cyysu/YSU-/README.md

# YSU-
燕山大学毕业设计-5V2A手机充电器设计，包括了原理图，PCB，开题报告，中期答辩以及最终的论文
