cyysu/YSU-/开题报告.pdf

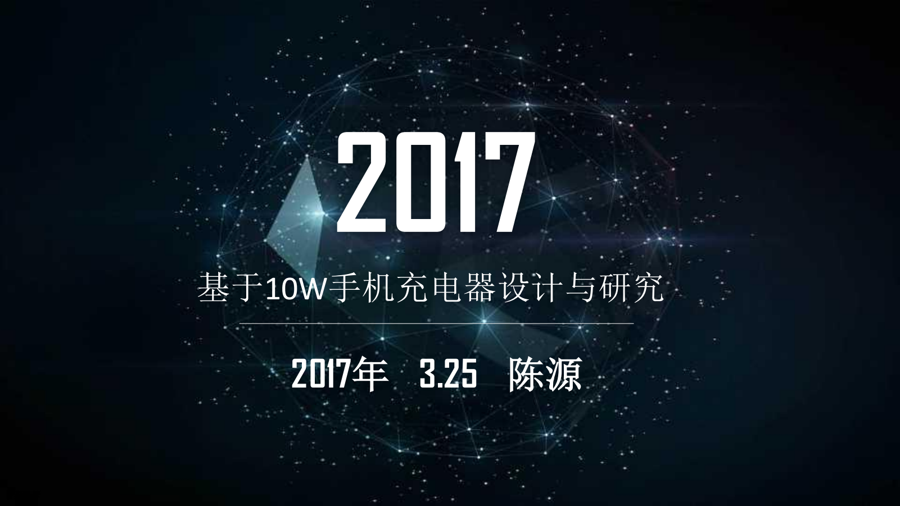
[picture p28: page 1]

# 基于10W手机充电器设计与研究

2017

PPT模板下载：www. 1ppt . com/ moban/ 行业PPT模板：www. 1ppt. com/ hangye/ 节日PPT模板：www. 1ppt . com/ jier i/ PPT素材下载：www. 1ppt .com/ sucai/ PPT背景图片：www. 1ppt . com/ beijng/ PPT图表下载：www. 1ppt .com/t ubiao/ 优秀PPT下载：www. 1ppt . com/ xiazai/ PPT教程：www. 1ppt . com/ power point/ Wor d教程：www. 1ppt . com /wor d/ Excel教程：www. 1ppt . com/ excel/ 资料下载：www. 1ppt . com /zilao/ PPT课件下载：www. 1ppt . com/ kejian/ 范文下载：www. 1ppt . com /f anwen/ 试卷下载：www. 1ppt . com/ shit i/ 教案下载：www. 1ppt . com /jiaoan/ PPT论坛：www. 1ppt . cn

# 2017年 3.25 陈源

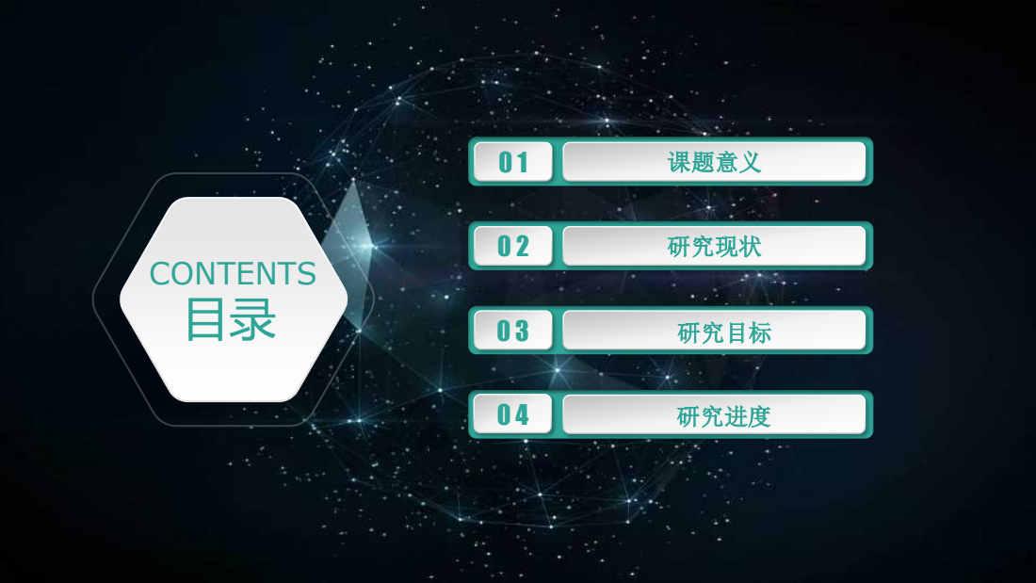
[picture p29: page 2]
CONTENTS; 课题意义; 研究现状; 研究目标; 研究进度

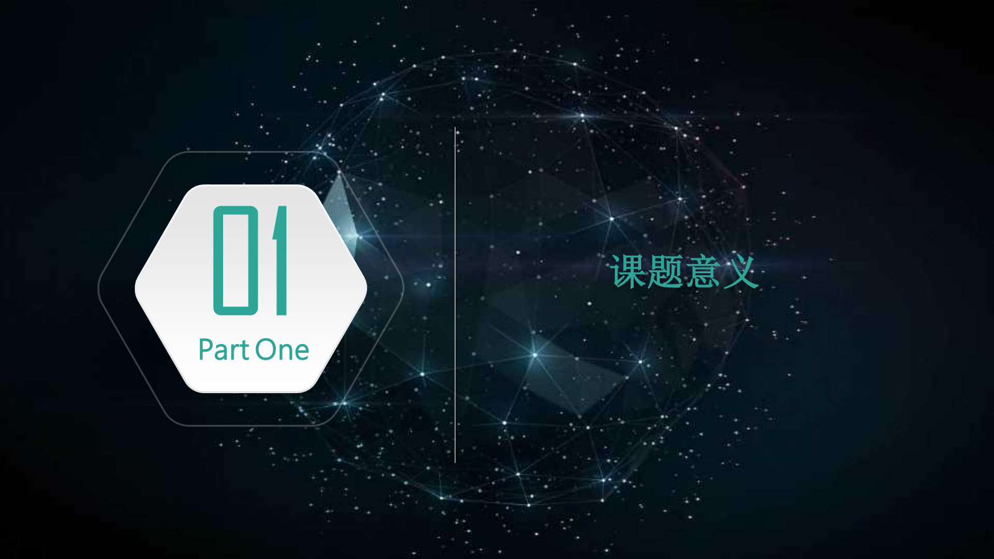
[picture p30: page 3]

01

# Part One

# 课题意义

# 01 研究意义

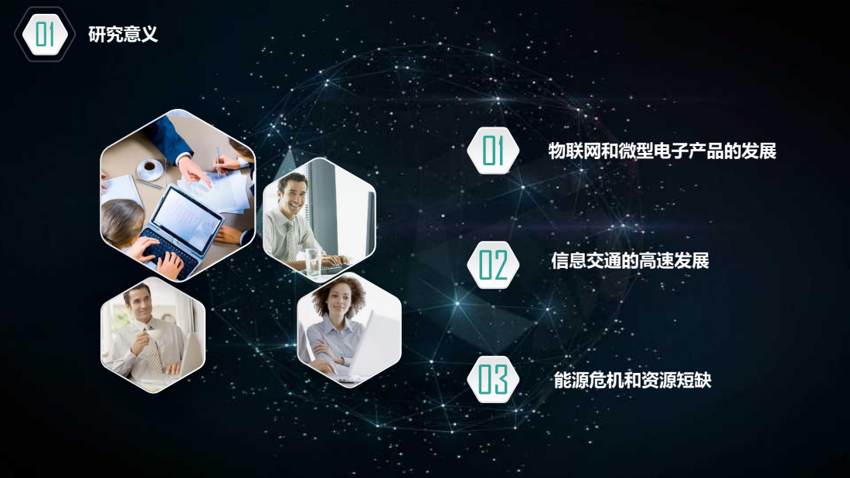
[picture p31: page 4]
物联网和微型电子产品的发展; 信息交通的高速发展; 能源危机和资源短缺

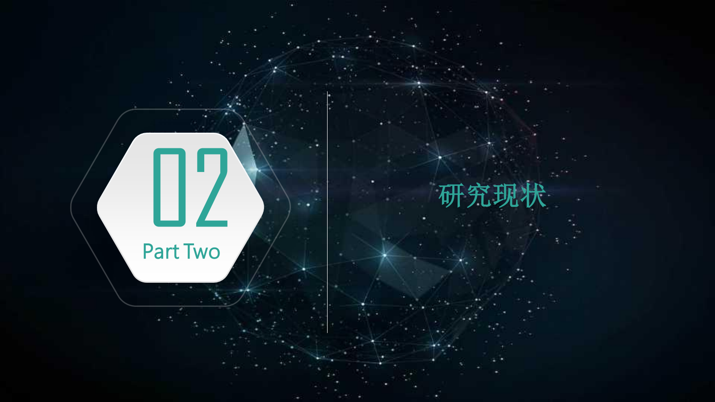
[picture p32: page 5]

02

# Part Two

# 研究现状

# 在QC2.0电压基础

# 上，采用独特INOV

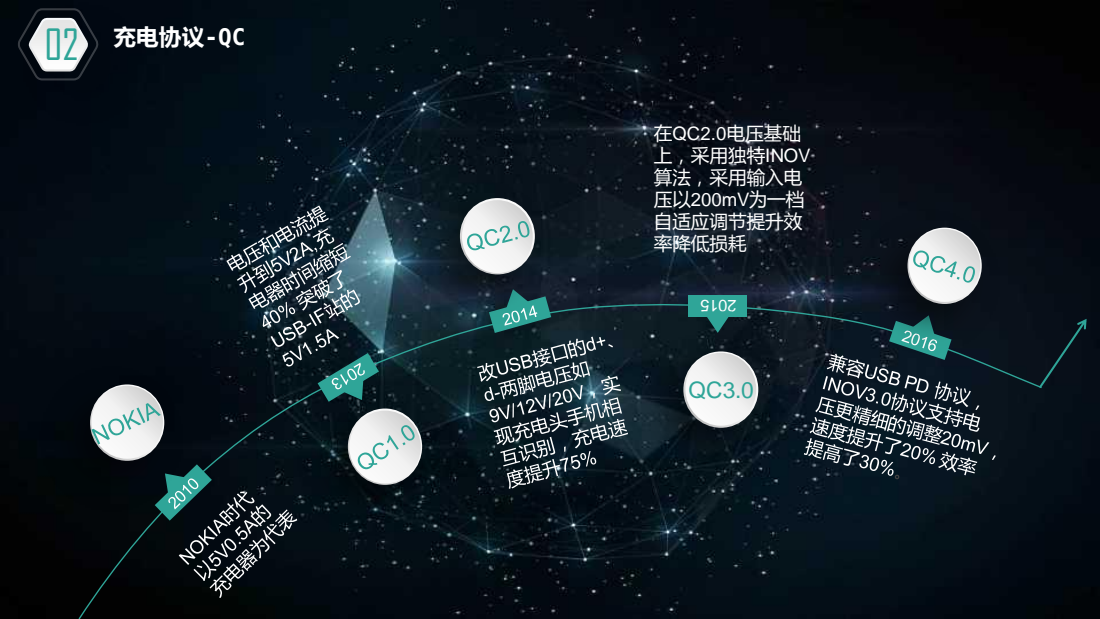
[picture p33: page 6]
算法，采用输入电 压以200mV为一档 自适应调节提升效 率降低损耗; 充电协议 -QC 02

# 接口标准 02

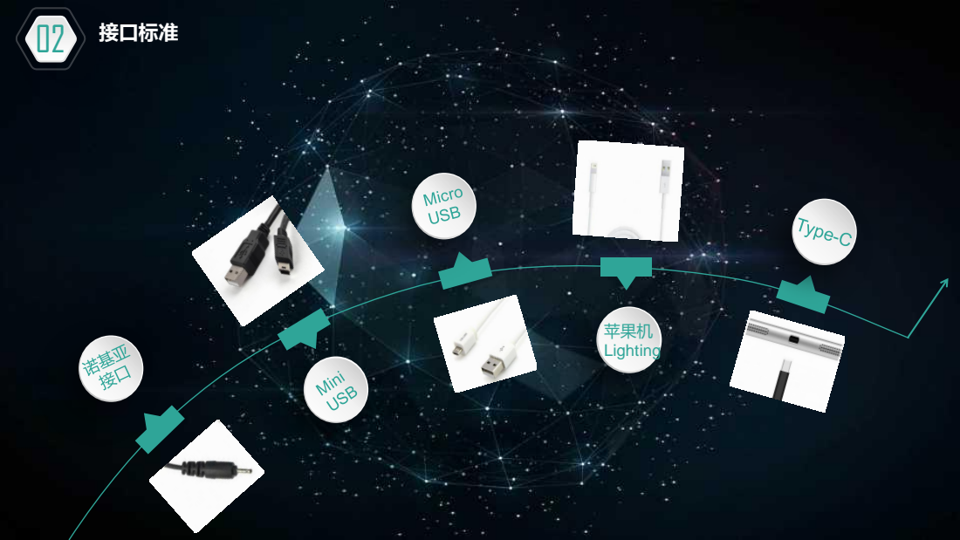
[picture p34: page 7]
苹果机 Lighting

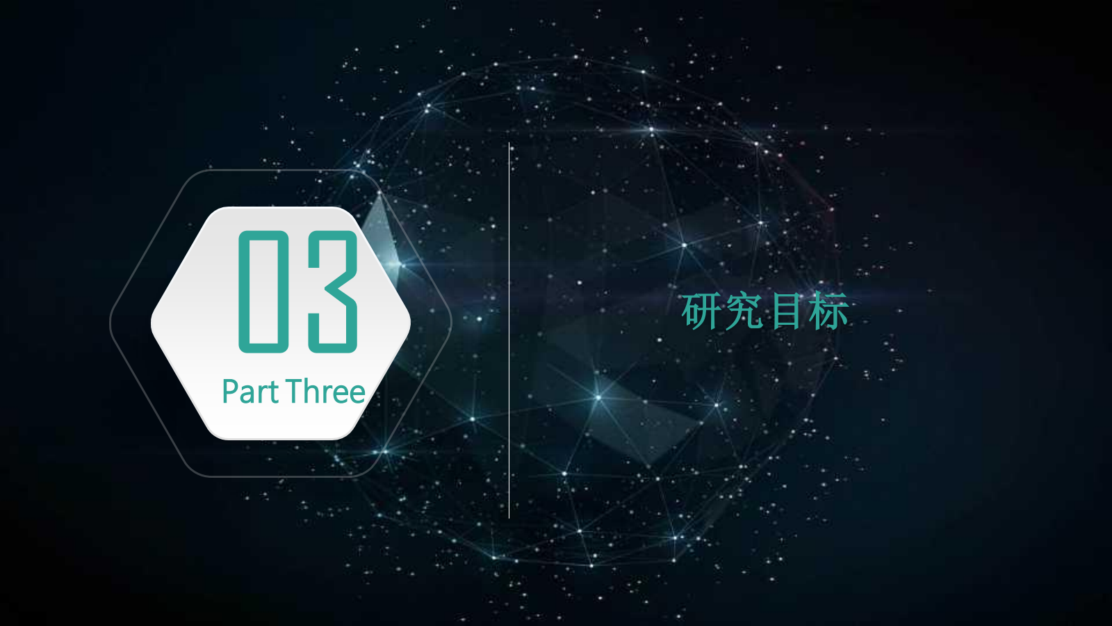
[picture p35: page 8]

03

# Part Three

# 研究目标

# 本课题主要针对以下三种方案进行理论分析，就其中一种或两种方案进行实物制作

# 03 研究方案

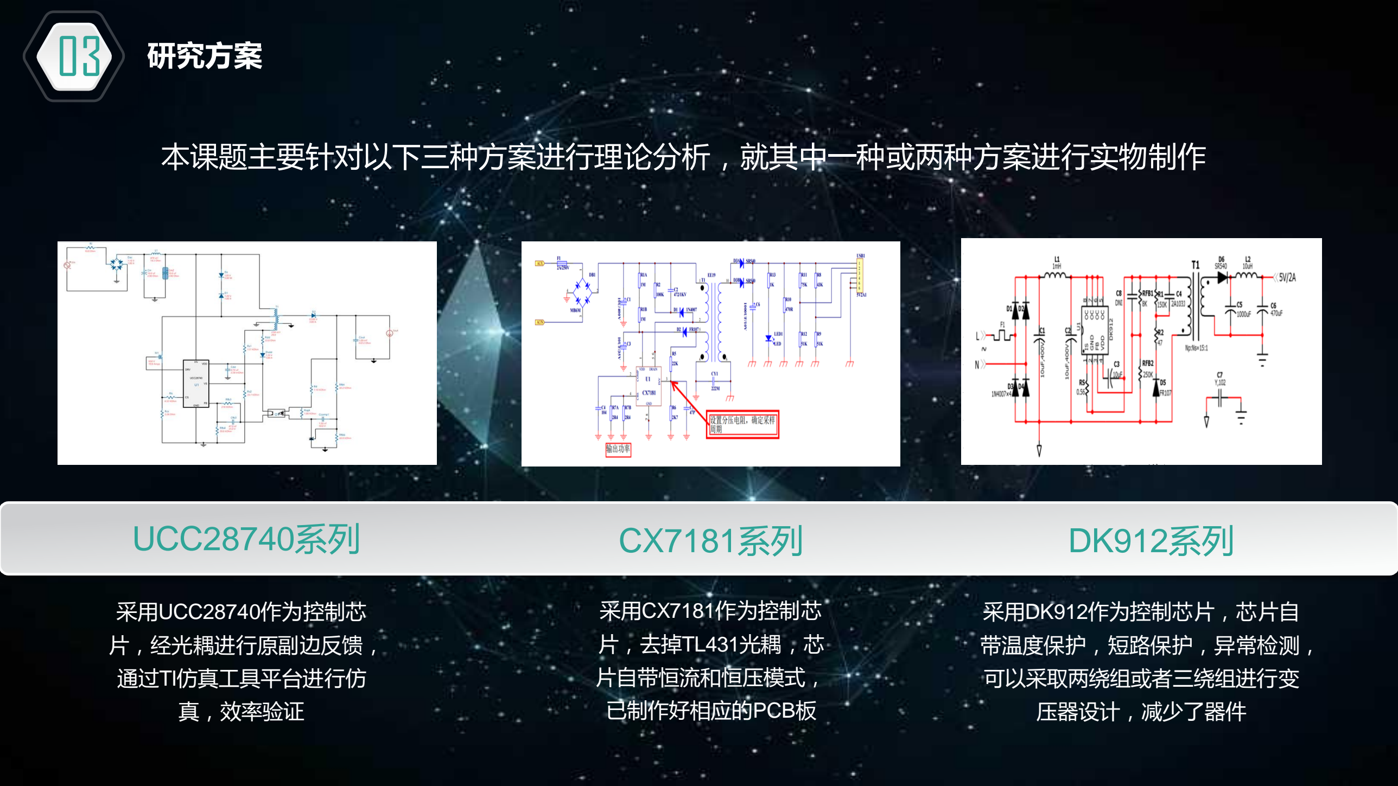
[picture p36: page 9]

# UCC28740系列

# 采用UCC28740作为控制芯

# 片，经光耦进行原副边反馈， 通过TI仿真工具平台进行仿 真，效率验证

# CX7181系列

# 采用CX7181作为控制芯

# 片，去掉TL431光耦，芯

# 片自带恒流和恒压模式， 已制作好相应的PCB板

# DK912系列

# 采用DK912作为控制芯片，芯片自

# 带温度保护，短路保护，异常检测，

# 可以采取两绕组或者三绕组进行变

# 压器设计，减少了器件

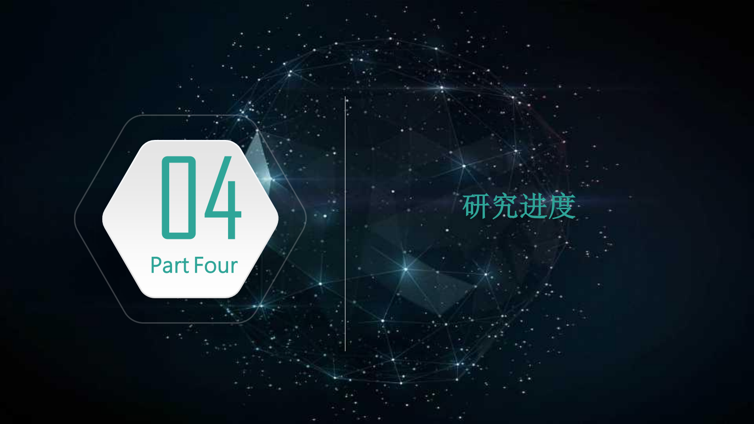
[picture p37: page 10]

04

# Part Four

# 研究进度

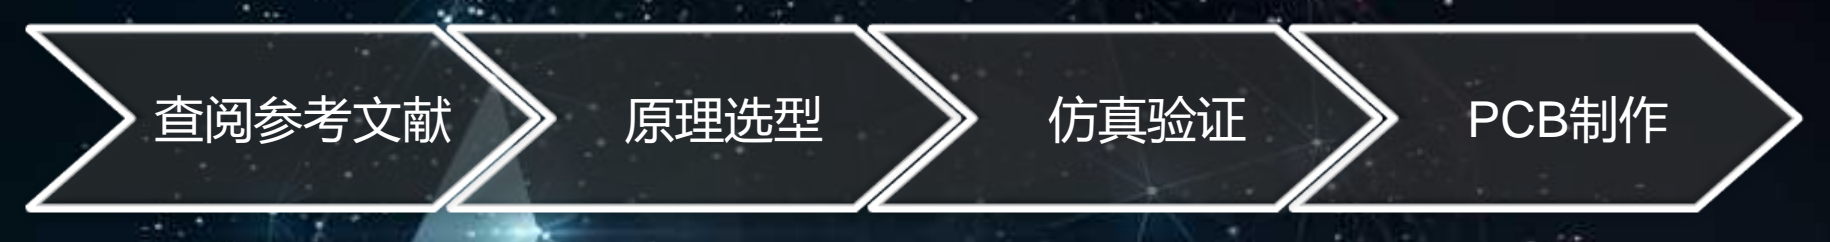
[picture p38: figure]
查阅参考文献; 原理选型; 仿真验证; PCB制作

# 初步选定以上三 种研究方案

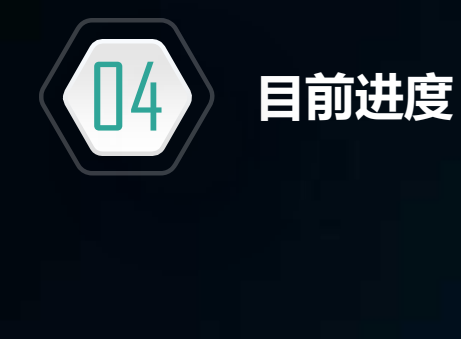
[picture p39: figure]
04 目前进度

# 查阅近3年内充

# 电器新型技术

# TI平台仿真验证 已初步分析

# CX7181元器件、电

# 路板准备完毕

# 附 充电器接口趋势图

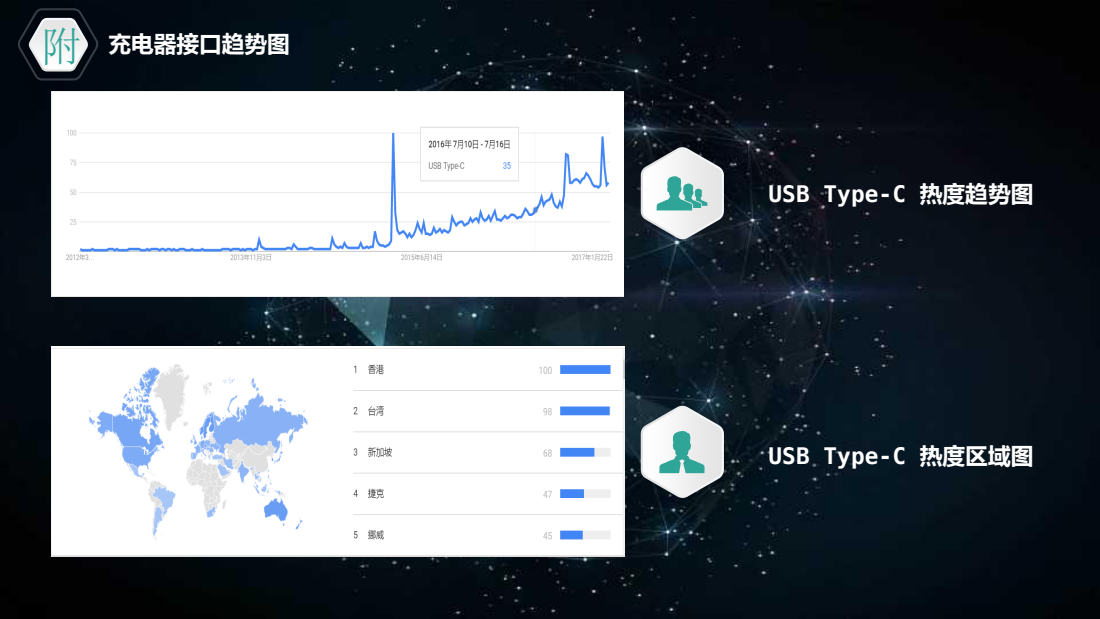
[picture p40: page 12]

USB Type-C 热度趋势图

USB Type-C 热度区域图

2017

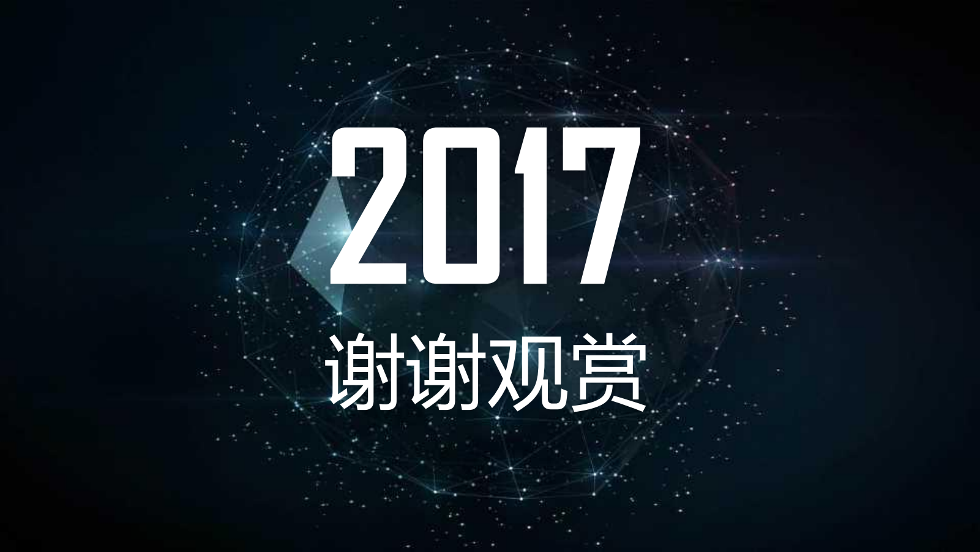
[picture p41: page 13]

# 谢谢观赏
