cyysu/YSU-/CX7181-0827/BOM for CX7181.xls

名称 | 封装 | 规格参数 | 数量 | 位置编号
贴片电容 | 0603 | 102 | 1 | C7
 | 0603 | 104 | 2 | C5 | C10
 | 0603 | 47P | 1 | C6
贴片电阻 | 0603 | 2.7K1% | 1 | R5
 | 0603 | 20K1% | 1 | R4
 | 0603 | 22R | 1 | R8
 | 0603 | 43K | 1 | R14
 | 0603 | 51K | 2 | R15 | R16
 | 0603 | 75K | 1 | R13
 | 0805 | 1M | 2 | R1 | R2
 | 0805 | 560R | 1 | R9
 | 1206 | 100K | 1 | R3
 | 1206 | 2.2R | 2 | R6 | R7
整流桥 | MBM | MB6M | 1 | DB1
电解电容 | 10*13 | 10uF/400V | 1 | C1
 | 4*7 | 10UF/35V | 1 | C4
 | 8*12 | 1000UF/10V | 1 | C8
瓷片电容 |  | 222/1KV | 1 | C3
安规Y电容 |  | 222M | 1 | CY1
二极管 | DO-41 | 1N4007 | 1 | D1
 | DO-15 | SR540 | 2 | D3 | D4
 | DO-41 | FR107 | 1 | D2
IC | DIP8 | CX7181 | 1 | U1
变压器 | EE19L4+3 | EE19 | 1 | T1
保险丝 |  | 2A/250V | 1 | F1
USB |  |  | 1 | USB
