cyysu/YSU-/TXY2685-四海通-ATC9213+9200D-5V2A/ATC9213 EE16不过认证 5V2A BOM .xls

5V2A充电配器成品物料明细
序号 |  | 元件名称 | 规格描述 | 用量
1 | R14 | PCB |  | 1
2 | BD1 | 桥堆 | Bridge Rectifiers MB10FM SOPA-4 (ROHS) | 1
3 | U1 | IC | Power Control IC ATC9213 SOP-7(ROHS) | 1
4 | U2 | IC | Power Control IC ATC9200D SOP-8(ROHS) | 1
5 | D1 D2 | 二极管 | F7 0.5A 1KV SOD-123FL | 2
6 | R1 R2 | 贴片电阻 | Chip resistor 1.4Ω±5% 1/4W 1206 (ROHS) | 2
7 | R3 | 贴片电阻 | Chip resistor 2MΩ±5% 1/4W 1206 (ROHS) | 1
8 | R4 | 贴片电阻 | Chip resistor 100KΩ±5% 1/4W 1206 (ROHS) | 1
9 | R5 | 贴片电阻 | Chip resistor 18KΩ±1% 1/8W 0805 (ROHS) | 1
10 | R6 | 贴片电阻 | Chip resistor 3KΩ±1% 1/8W 0805 (ROHS) | 1
11 | R7 | 贴片电阻 | Chip resistor 1KΩ±5% 1/8W 0805 (ROHS) | 1
12 | R8 | 贴片电阻 | Chip resistor 22Ω±5% 1/12W 0603 (ROHS) | 1
13 | R9 | 贴片电阻 | Chip resistor 270Ω±5% 1/12W 0603 (ROHS) | 1
14 | R10 | 贴片电阻 | Chip resistor 27KΩ±5% 1/12W 0603 (ROHS) | 1
15 | R11 | 贴片电阻 | Chip resistor 1KΩ±5% 1/12W 0603 (ROHS) | 1
16 | R12 | 贴片电阻 | Chip resistor 110KΩ±5% 1/12W 0603 (ROHS) | 1
17 | R13 | 贴片电阻 | Chip resistor 330KΩ±5% 1/12W 0603 (ROHS) | 1
18 | R14 | 贴片电阻 | Chip resistor 43KΩ±5% 1/12W 0603 (ROHS) | 1
19 | R15 R16 | 贴片电阻 | Chip resistor 51KΩ±5% 1/12W 0603 (ROHS) | 2
20 | R17 | 贴片电阻 | Chip resistor 75KΩ±5% 1/12W 0603 (ROHS) | 1
21 | C1 | 贴片电容 | Chip Cap 102±20% 500V 0805 (ROHS) | 1
22 | C2 | 贴片电容 | Chip Cap 472±20% 50V 0603 (ROHS) | 1
23 | C3 | 贴片电容 | Chip Cap 105±20% 50V 0603 (ROHS) | 1
插件
24 | F1 | 保险丝电阻 | 4.7R/1/2W 绕线电阻 | 1
25 | EC1 | 电解电容 | E.Cap 10UF/400V±20% Φ8*13mm 105℃(ROHS+PET) | 1
26 | EC2 | 电解电容 | E.Cap 10UF/50V±20% Φ4*7mm 105℃(ROHS+PET) | 1
27 | EC3 EC4 | 电解电容 | E.Cap 470UF/6.3V±20% Φ6*12mm 高频低阻 | 2
28 | CY1 | 瓷片电容 | 高压瓷片 102/1KV 脚距5MM | 1
29 | T1 | 变压器 | EE16 L=1.0mH (5+5)(ROHS) | 1
30 | LED1 |  |  | 1
31 | USB1 USB2 |  |  | 2
