cyysu/YSU-/现阶段研究的AT9213方案/ATC9213 EE16 5V2A BOM.xls

5V2A充电配器成品物料明细
序号 | 元件代码 | 元件名称 | 规格描述 | 用量
1 | PCB板 | PCB |  | 1
2 | BD1 | 桥堆 | Bridge Rectifiers MB10FM SOPA-4 (ROHS) | 1
3 | IC1 | IC | Power Control IC ATC9213 SOP-8(ROHS) | 1
4 | D1 D2 | 二极管 | A7 0.5A 1KV SOD-123FL | 2
5 | R1 R2 | 贴片电阻 | Chip resistor 1MΩ±5% 1/4W 1206 (ROHS) | 2
6 | R3 R4 | 贴片电阻 | Chip resistor 1.3Ω±5% 1/4W 1206 (ROHS) | 2
7 | R5 | 贴片电阻 | Chip resistor 100KΩ±5% 1/4W 1206 (ROHS) | 1
8 | R7 | 贴片电阻 | Chip resistor 3.3KΩ±1% 1/8W 0805 (ROHS) | 1
9 | R8 | 贴片电阻 | Chip resistor 21KΩ±5% 1/8W 0805 (ROHS) | 1
10 | R9 | 贴片电阻 | Chip resistor 470Ω±5% 1/8W 0805 (ROHS) | 1
11 | R10 | 贴片电阻 | Chip resistor 10Ω±5% 1/8W 0805 (ROHS) | 1
12 | R12 | 贴片电阻 | Chip resistor 100Ω±5% 1/8W 0805 (ROHS) | 1
13 | C3 | 贴片电容 | Chip Cap 102±20% 50V 0805 (ROHS) | 1
插件
14 | F1 | 保险丝 | T1A250VAC 插件 3.6*10mm (ROHS) | 1
15 | CY1 | Y电容 | Y电容 222 400V ±20% 脚距:10mm F(JD) | 1
16 | C1 | 高压瓷片电容 | 102/1KV 脚距：5mm | 1
17 | EC1 EC2 | 电解电容 | E.Cap 6.8UF/400V±20% Φ8*14mm 105℃(ROHS+PET) | 2
18 | EC3 | 电解电容 | E.Cap 10UF/50V±20% Φ4*7mm | 1
19 | EC4 EC5 | 电解电容 | E.Cap 470UF/6.3V±20% Φ6.3*12mm 高频低阻 | 2
20 | D3 | 二极管 | S-Diode SR540L 5A/40V DO-201 | 1
21 | L1 | 跳线 | 0.6MM*4.5MM跳线 | 1
22 | T1 | 变压器 | EE16 V01 L=1.0mH (5+5)(ROHS) | 1
23 | USB |  |  | 1
