cyysu/YSU-/CX7181-0827/cx7181 EPC17骨架的变压器资料.xls

变压器规格书
用途： |  |  |  |  |  | 标贴型号 | ：CX7181-10W
名称： | 10W-CX7181 |  |  |  | √ | 打样数量：5只
样品版本：V1.0 |  |  |  |  |  | 交样日期 ： 月 日
磁芯规格：EPC17卧式 TDK PC40 |  |  |  | 骨架规格：EPC17 6+4脚
 |  |  |  |  |  | outside
 |  |  |  | top
 | 原理图 |  |  |  |  | N3
 |  |  |  |  |  | N2
 |  |  |  | bottom |  | N1
绕 组 | 引脚 | 线径 | 匝数 | 参考要求 | 上端间距 | 下端间距 | 胶带层数 | 绕制方法
N1 | 5--1 | Φ0.23×1 | 110T | 初级绕组 |  |  | 底层 | 三层密绕
N2 | 7--10 | Φ0.45*2 | 9T | 5V/2.1A |  |  | 3 | 两层密绕
N3 | 6--3 | Φ0.23×1 | 26T | 15V/10mA |  |  | 3 | 密绕铺满
注: | 分压电阻为21K:3K
技术要求： | 1、N1.N3.N4为原边，N2为副边。
 | 2、如果不能绕制整层，就平均疏绕整层。
 | 3、浸漆绝缘处理。
初级电感量920uH±3%,短路次级漏感小于50uH,磁芯气隙0.3mm(参考值）。
1、安规绝缘符合国标GB8898-1997的相关要求。辐射干扰符合国标GB13837的相关要求。 2、若有不足以满铺整层，请稀绕铺满。 3、变压器谐振频率应在1MHz以上。（Dmax=0.55 F=100KHz)
