cyysu/YSU-/CX7181-0827/7181 EE19变压器资料4+3.xls

变压器规格书
用途： |  |  |  |  |  | 标贴型号 | ：CXW7181-10W
名称： | 10W-CXW7181 |  |  |  | √ | 打样数量：5只
样品版本：V1.0 |  |  |  |  |  | 交样日期 ： 月 日
磁芯规格：EE19立式 TDK PC40 |  |  |  | 骨架规格：EE19 4+3脚（脚距4mm,排距11mm)
 |  |  |  | top
 | 原理图 |  |  |  |  | N3
 |  |  |  |  |  | N2
 |  |  |  | bottom |  | N1
绕 组 | 引脚 | 线径 | 匝数 | 绕组名称 | 绕向 | 绕制方法 | 胶带层数 | 备注
N1 | 3--4 | Φ0.23×1 | 110T | 初级绕组 | 顺时针 | 三层密绕 | 底层
N2 | 7--5 | 0.45*2 | 9T | 次级绕组 | 顺时针 | 平均铺满 | 3
N3 | 1--2 | Φ0.23×1 | 27T | 反馈绕组 | 顺时针 | 平均铺满 | 3
 |  |  |  |  |  |  | 外2层
注:
技术要求：
 | 1、真空浸漆绝缘处理。
 | 2、3750V打高压
初级电感量930UH±3%,短路次级漏感小于50uH,磁芯气隙0.3mm(参考值）。
1、安规绝缘符合国标GB8898-1997的相关要求。辐射干扰符合国标GB13837的相关要求。 2、若有不足以满铺整层，请稀绕铺满。 3、变压器谐振频率应在1MHz以上。（Dmax=0.55 F=100KHz)
