cyysu/YSU-/CX7181-0827/插件贴片图.pdf

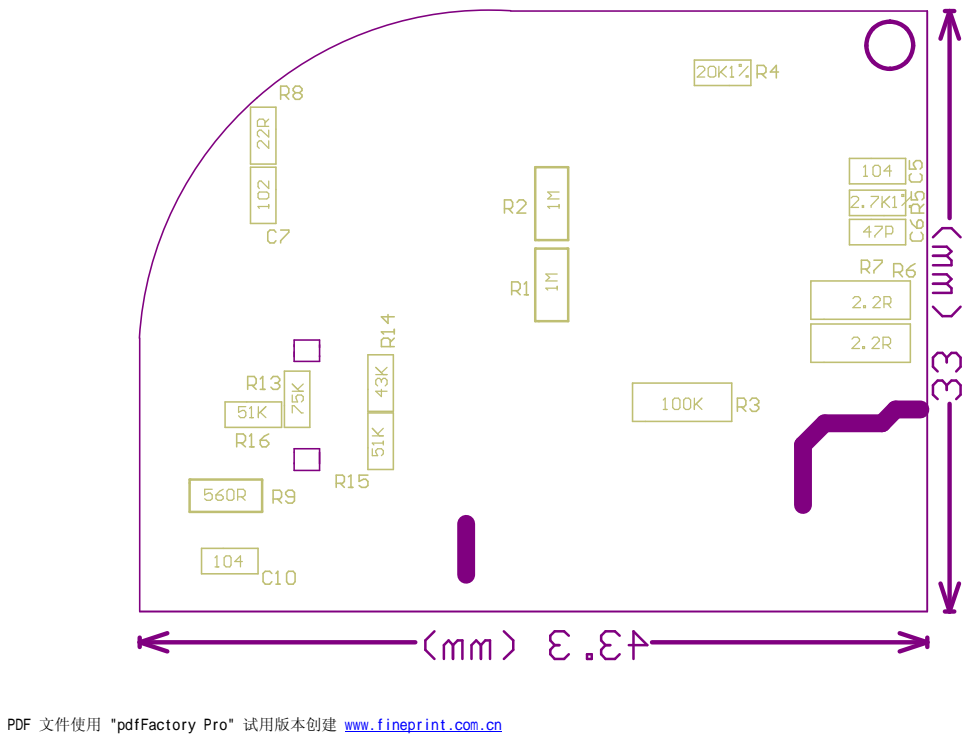
[picture p43: page 1]

PDF 文件使用 "pdfFactory Pro" 试用版本创建 www.fineprint.com.cn

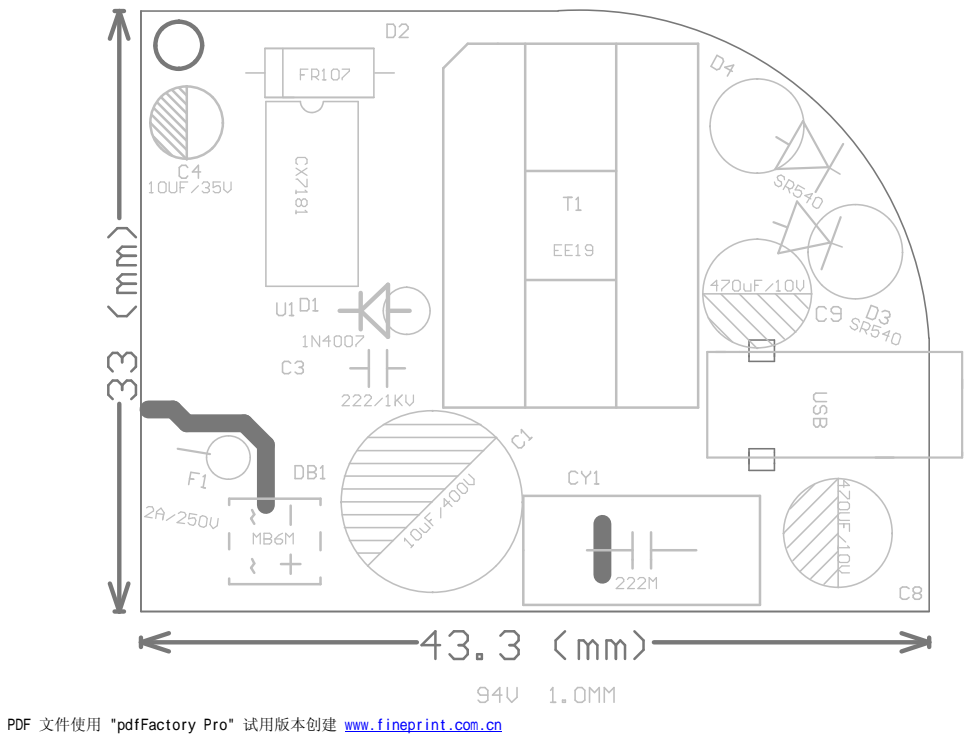
[picture p44: page 2]

PDF 文件使用 "pdfFactory Pro" 试用版本创建 www.fineprint.com.cn
