cyysu/YSU-/TXY2685-四海通-ATC9213+9200D-5V2A/ATC9213 原理图.pdf

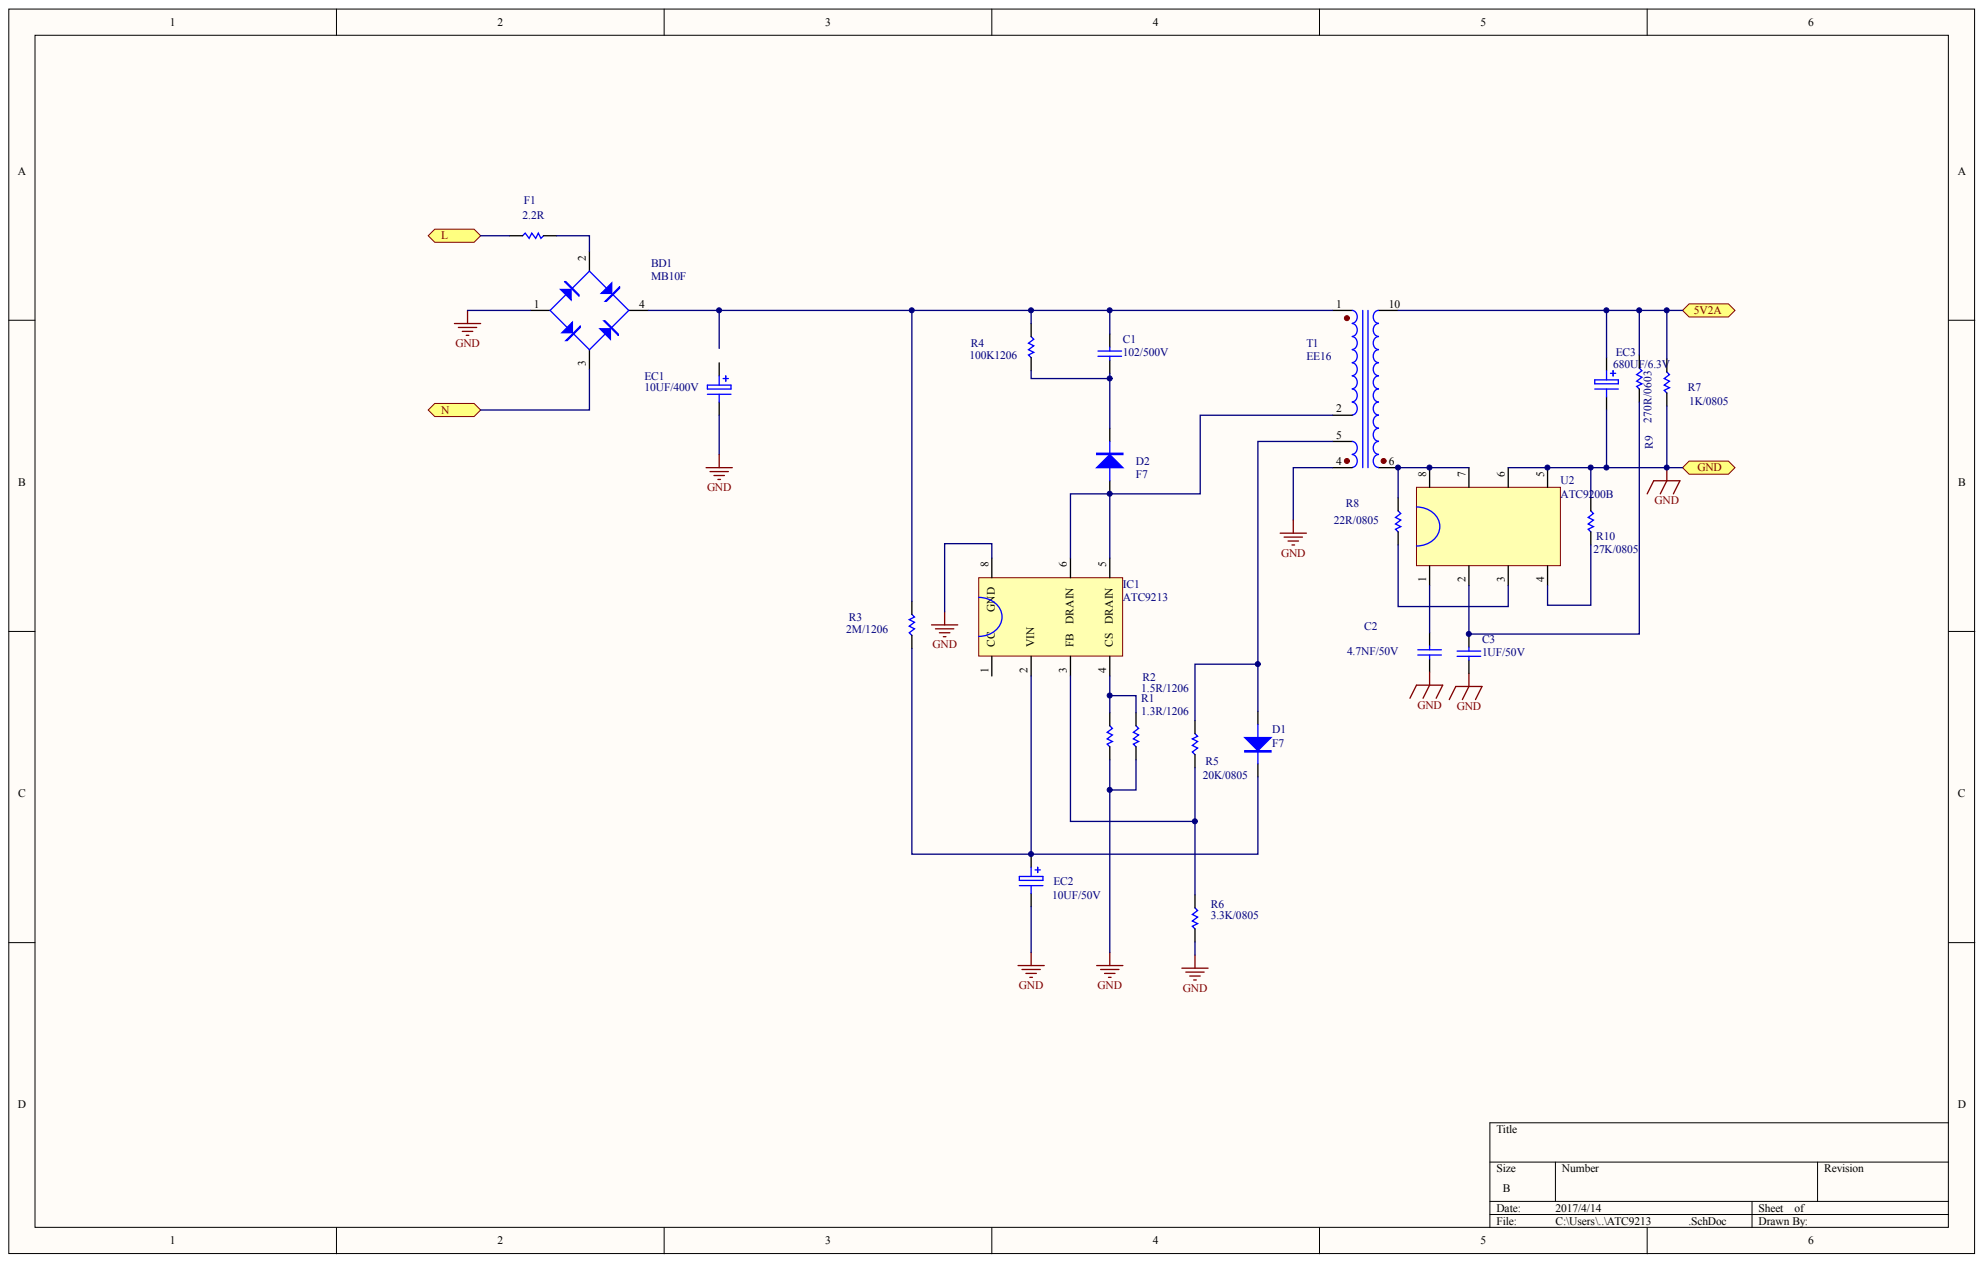
[picture p45: page 1]
