cyysu/YSU-/TXY2685-四海通-ATC9213+9200D-5V2A/变压器 EE16卧式 5+5 5V2A 不过认证.pdf

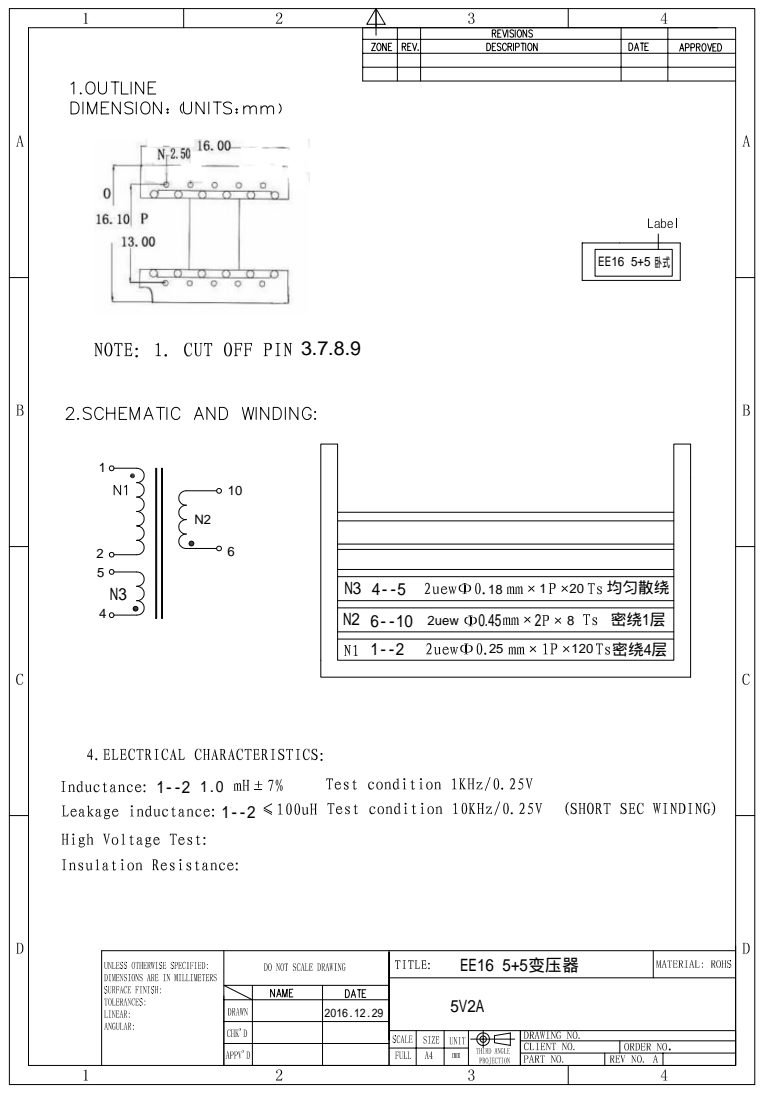
[picture p46: page 1]
均匀散绕; 2uew 4; EE16 5+5变压器
