cyysu/YSU-/现阶段研究的AT9213方案/ATC9213 5V2A SCH.pdf

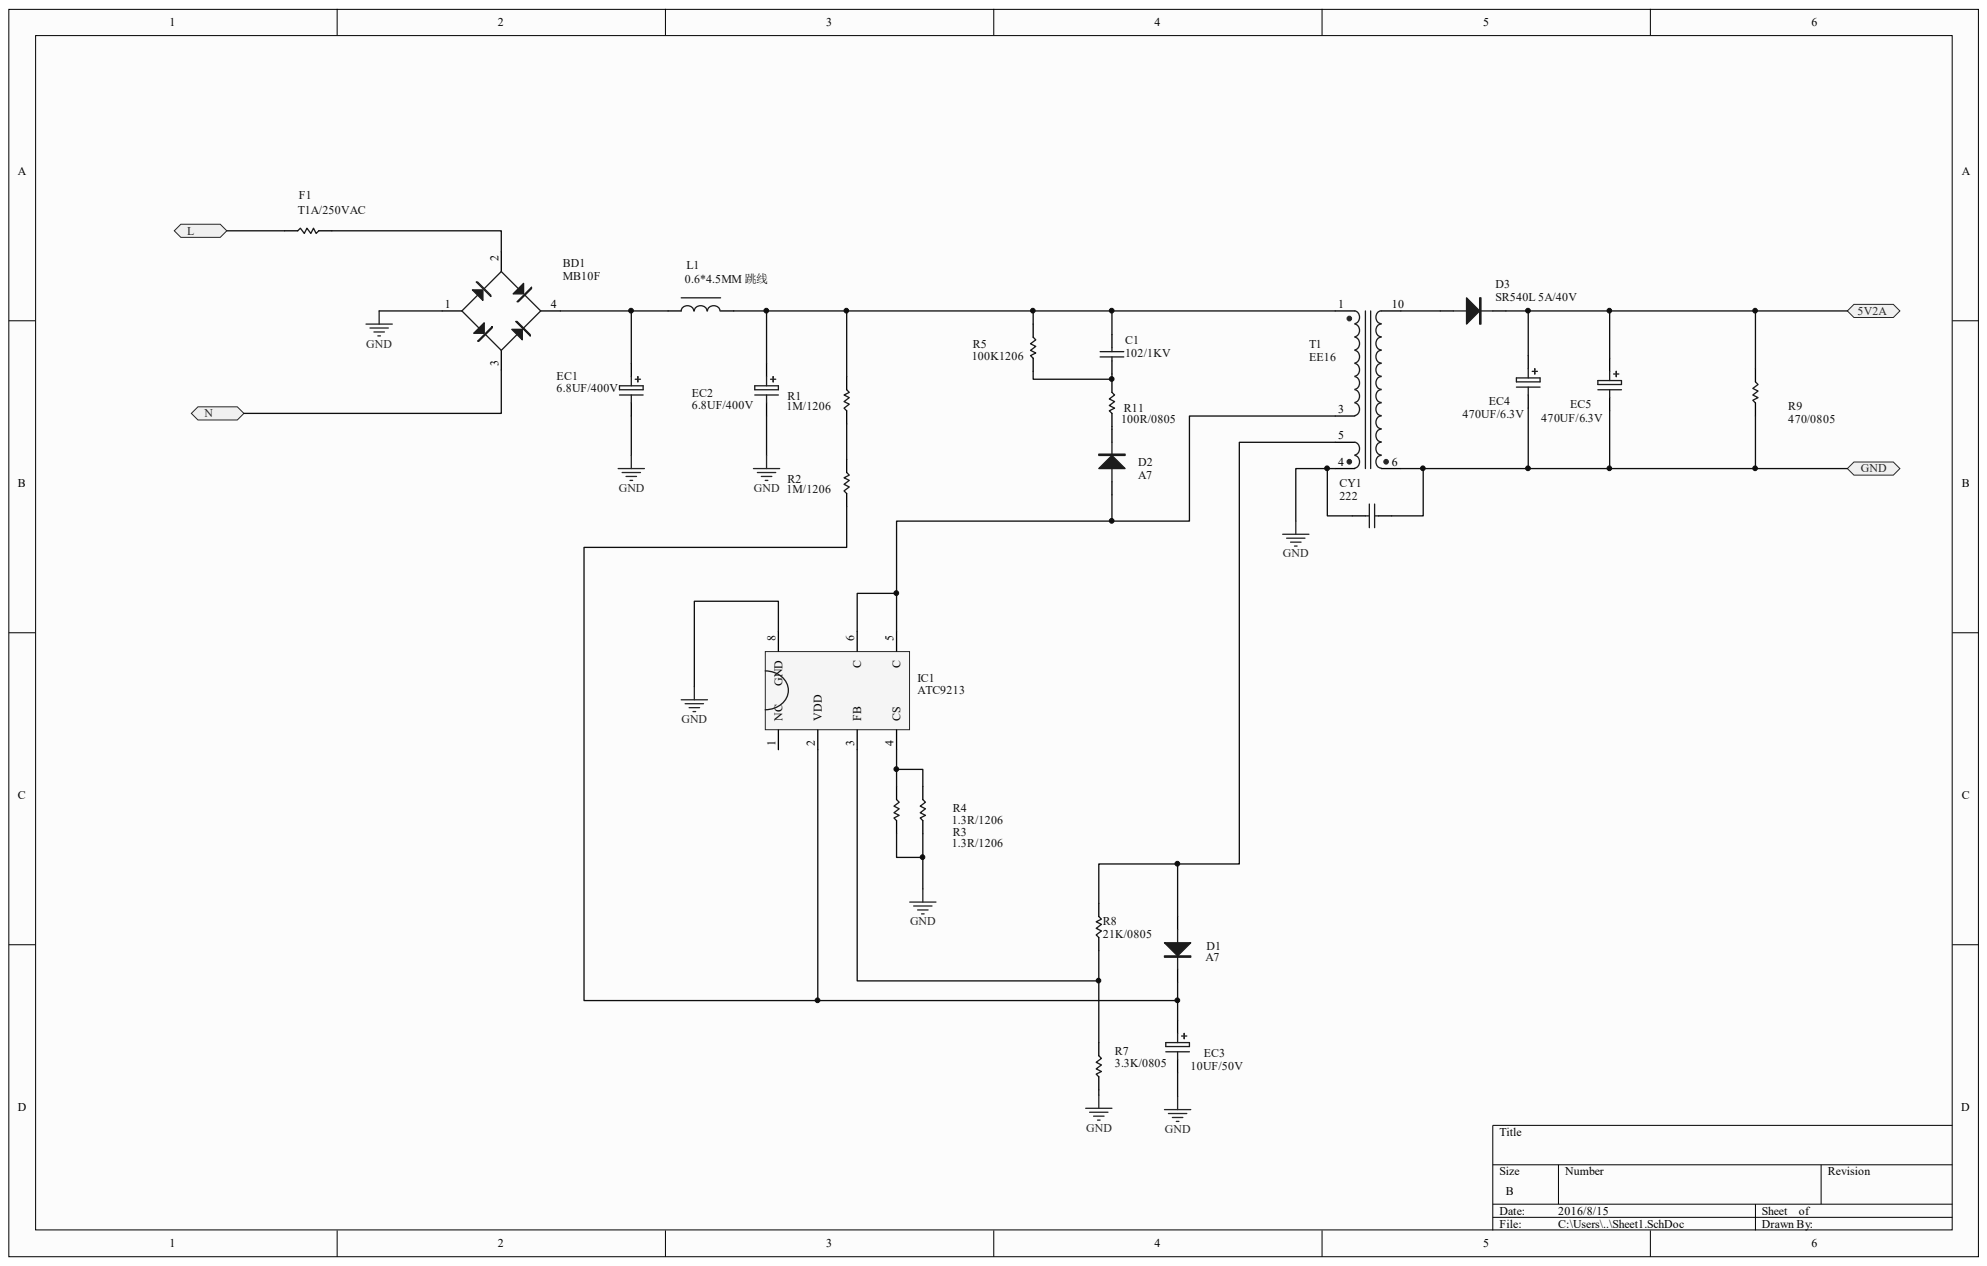
[picture p47: page 1]
