cyysu/YSU-/现阶段研究的AT9213方案/变压器 EE16立式 5+5 5V2A.pdf

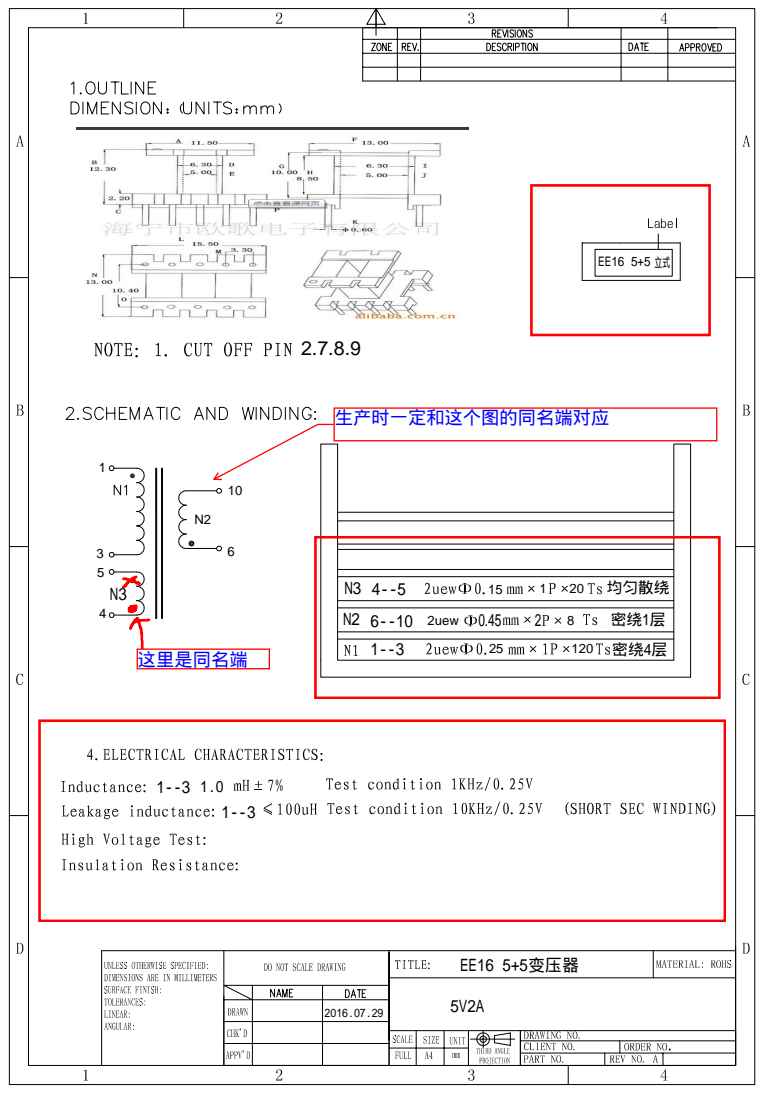
[picture p48: page 1]
均匀散绕; 2uew 4; EE16 5+5变压器
