cyysu/YSU-/(list of files, drawings)

Other design files:
CX7181-0827/CX7181.PCB
TXY2685-四海通-ATC9213+9200D-5V2A/ATC9213 原理图.SchDoc
现阶段研究的AT9213方案/Sheet1.SchDoc
